CodingClub-IITD-AD/Artbot/image.png

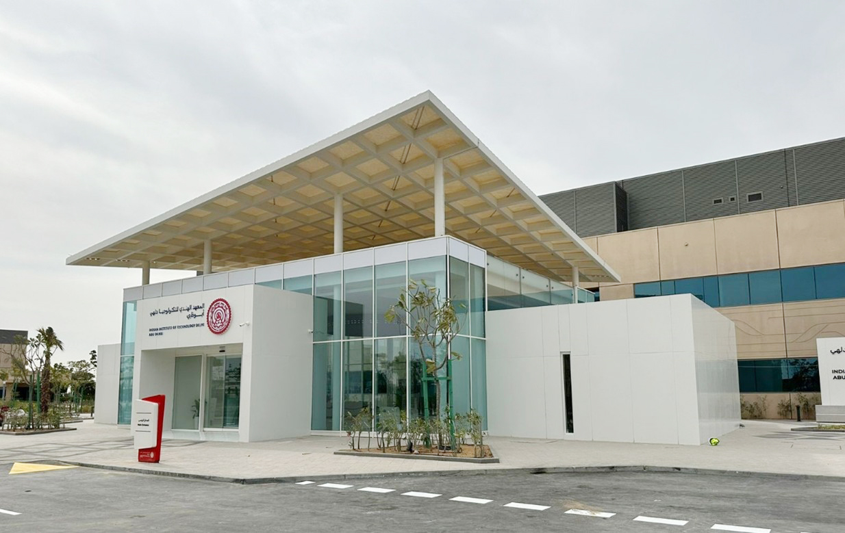
image.png
