CodingClub-IITD-AD/Artbot/cad/out/preview_carriage.png

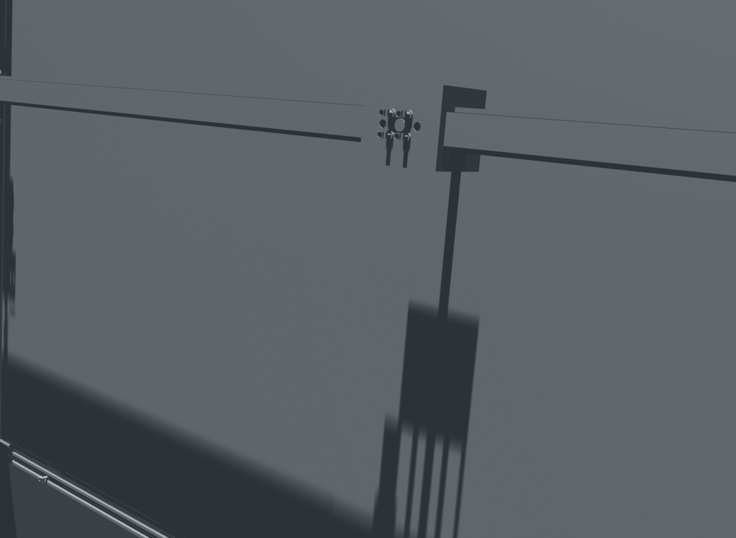
cad/out/preview_carriage.png
