CodingClub-IITD-AD/Artbot/cad/out/artbot_assembly.step

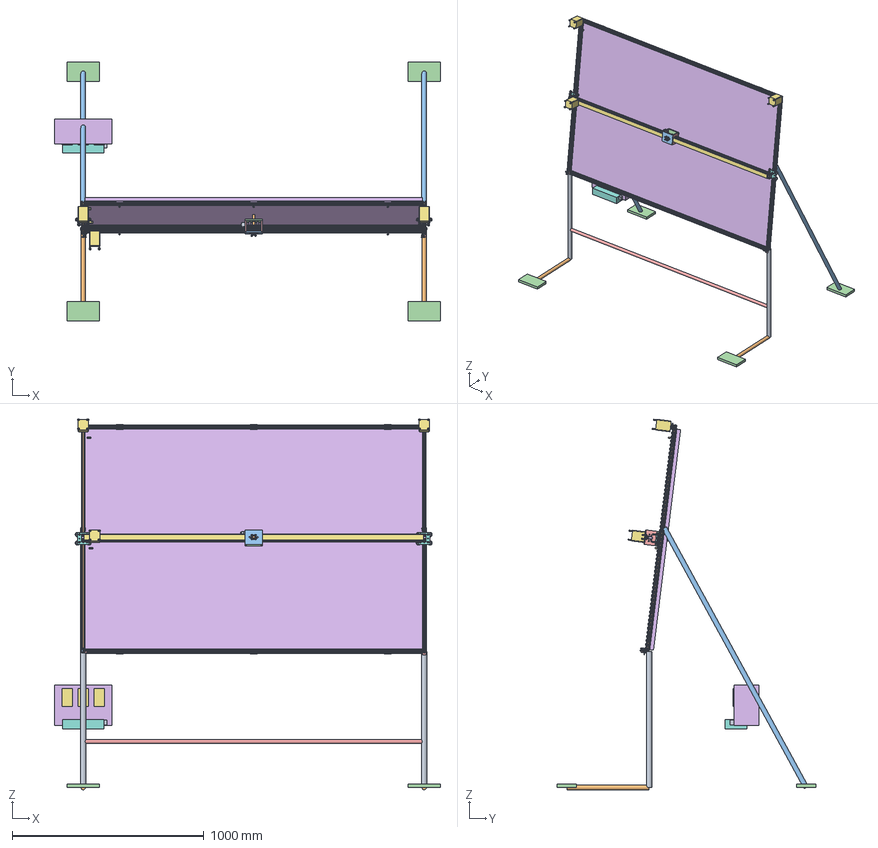
[picture p11: CAD file, 2026-09-07]
cad/out/artbot_assembly.step
2015.0 x 1350.0 x 1934.7 mm
