CodingClub-IITD-AD/Artbot/cad/out/print_carriage_mount_plate.stl

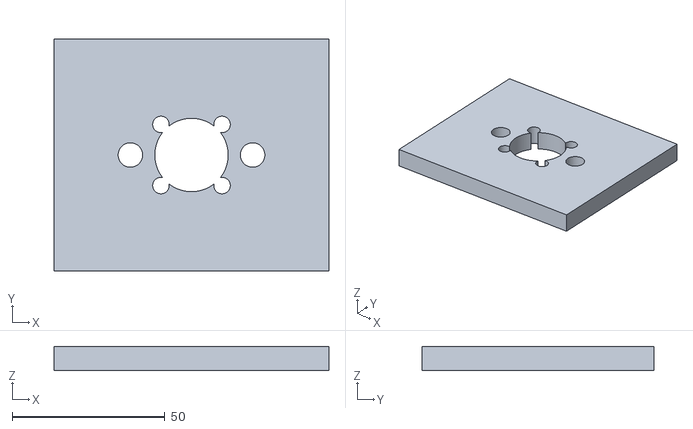
[picture p12: CAD file, 2026-09-07]
cad/out/print_carriage_mount_plate.stl
90.0 x 76.0 x 8.00
