CodingClub-IITD-AD/Artbot/cad/out/print_carriage_rib_-1.stl

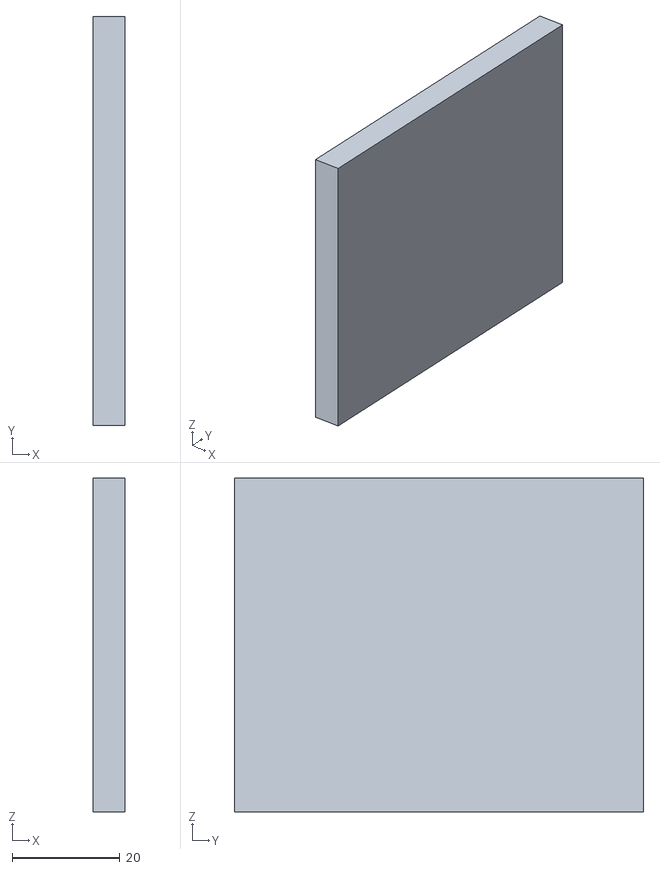
[picture p13: CAD file, 2026-09-07]
cad/out/print_carriage_rib_-1.stl
6.00 x 76.0 x 62.0
