CodingClub-IITD-AD/Artbot/cad/out/print_pen_shuttle.stl

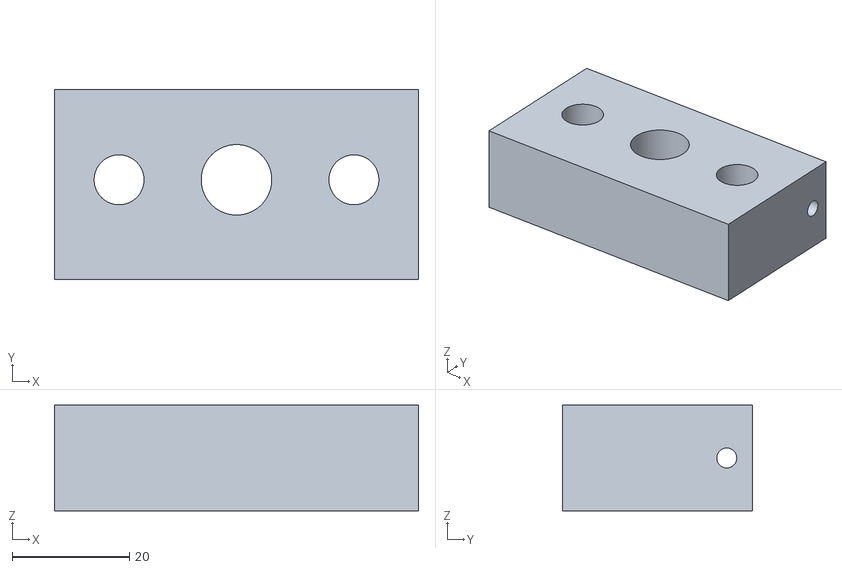
[picture p14: CAD file, 2026-09-07]
cad/out/print_pen_shuttle.stl
62.0 x 32.4 x 18.0
