CodingClub-IITD-AD/Artbot/(list of files, cad)

Other CAD files:
cad/out/print_carriage_front_wall.stl
cad/out/print_carriage_rib_1.stl
