CodingClub-IITD-AD/Artbot/cad/out/preview_assembly.png

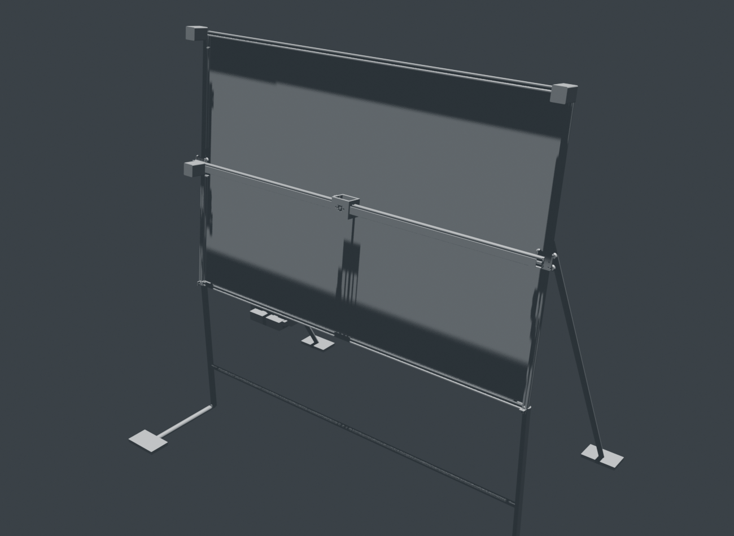
cad/out/preview_assembly.png
