CodingClub-IITD-AD/Artbot/tests/test_image.png

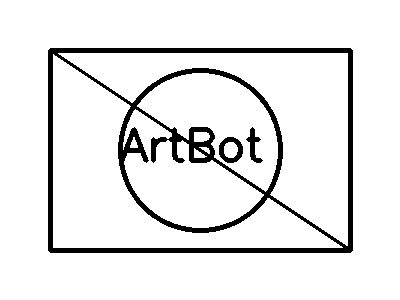
tests/test_image.png
