CodingClub-IITD-AD/Artbot/config/machine.yaml

machine:
  frame_width_mm: 1800
  frame_height_mm: 1200
  buffer_mm: 50
  work_area_width_mm: 1700
  work_area_height_mm: 1100
  origin: top-left
motion:
  draw_feed_rate: 3000
  rapid_feed_rate: 5000
  steps_per_mm: 80.0
pen:
  down_command: M3 S90
  up_command: M5
  settle_time_ms: 150
processing:
  mode: auto
  threshold: 128
  downscale_factor: 0.49
  clahe_clip: 3.7
  clahe_grid: 8
  xdog_sigma: 0.5
  xdog_k: 314
  xdog_p: 0.98
  xdog_epsilon: -0.1
  xdog_phi: 10.0
  morph_close_kernel: 3
  min_blob_area: 92
  min_arc_length: 30
  min_contour_area: 80
  simplify_epsilon: 1.5
  min_contour_points: 3
