CodingClub-IITD-AD/Artbot/(commit log)

2026-02-23 Add initial Artbot project structure
    - artbot/: Core package with image processing (preprocess, trace),
    G-code generation (generator, clipping, path_sorting), and utils
    - config/: Machine configuration (machine.yaml)
    - scripts/: CLI tools (convert.py, simulate.py)
    - tests/: Test assets (test_image.png)
    - docs/: Implementation plan and task tracking
    - .gitignore, requirements.txt
    [machine.yaml]
2026-02-23 more updates
    [machine.yaml]
2026-03-10 Fix driver reference: TMC2209 → TB6600 in CLAUDE.md
    NEMA 23 motors need more current than TMC2209 can provide.
2026-09-07 Add design pack: CAD, 3D mockups, shopping list, wiring spec
    The 2026-08-31 design session was never committed. This lands all of it,
    plus a revision to the electronics spec from a follow-up review.
    New:
    - cad/artbot_cad.py, build123d parametric model, 148 B-rep solids,
    exports artbot_assembly.step (opens in Fusion/SolidWorks/FreeCAD) plus
    individual printable-part STLs. The 20 MB assembly STL is gitignored,
    regenerate with `python cad/artbot_cad.py`.
    - cad/*.scad, 7 OpenSCAD parts. First pass, still needs revision for the
    rack-at-bottom change.
    - viz/mockup-v2.html, interactive 3D model with a clickable 21-item BOM
    and a live engineering panel (rail sag, torque margin, tipping an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
    [artbot_assembly.step, belt_clamp_gt2.scad, idler_bracket_2020.scad, limit_switch_mount_2020.scad, params.scad, pen_carriage_base.scad, pen_shuttle.scad, print_carriage_front_wall.stl]
2026-09-07 Correct the DM542 clone warning: counterfeiting is a TB6600 problem
    Verified against Leadshine/StepperOnline datasheets and driver comparisons.
    Two fixes to the driver section pushed in 1bf569f:
    - The clone-quality caution was pointed at the wrong part. TB6600 bricks
    are the ones widely faked (TB67S109 or cheaper in place of the Toshiba
    chip); DM542 has no comparable reported problem. Strengthens the DM542
    case rather than weakening it.
    - "9-42 V means fake" was too clean a test. Legitimate DM542 variants
    ship at 20-50 V and 18-50 V, plus a real 24-60 V variant that IS wrong
    for a 24 V PSU because 24 V is its floor. Spelled out per-range.
    Also adds current-setting method (DIP vs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
